CoolNamesAllTaken/geeps-hardware/README.md

# geeps-hardware
Pronounced Gee-Pee-Ess (hardware).
