CoolNamesAllTaken/geeps-hardware/excel/design_calculations.xlsx

Parameter | Value | Value | Value | Value | Unit | Note
Color | Red | Red | Green | Green
LED PN | SML-D12U8WT86 | SML-D12U8WT87 | SML-D12M8WT86 | SML-D12M8WT87
V_dd | 3.3 | 5 | 3.3 | 5 | V | Positive supply voltage.
V_f | 2.2 | 2.2 | 2.2 | 2.2 | V
LI_target | 12 | 12 | 12 | 12 | mcd | Target luminous intensity.
LI/I_f | 3.15 | 3.15 | 1.25 | 1.25 | mcd/mA
I_f | 3.81 | 3.81 | 9.60 | 9.60 | mA | Forward current.
R | 288.75 | 735 | 114.5833333 | 291.6666667 | Ohms
P_R | 0.004 | 0.011 | 0.011 | 0.027 | W | Power dissippated in resistor.
R (closest 1% standard value) | 287 | 732 | 115 | 294
Resistor PN | RC0402FR-07287RL | RC0402FR-07732RL | RC0402FR-07115RL | RC0402FR-07294RL
