CoolNamesAllTaken/geeps-hardware/solidworks/geeps_thtelth/decals/epaper_screenshot.jpg

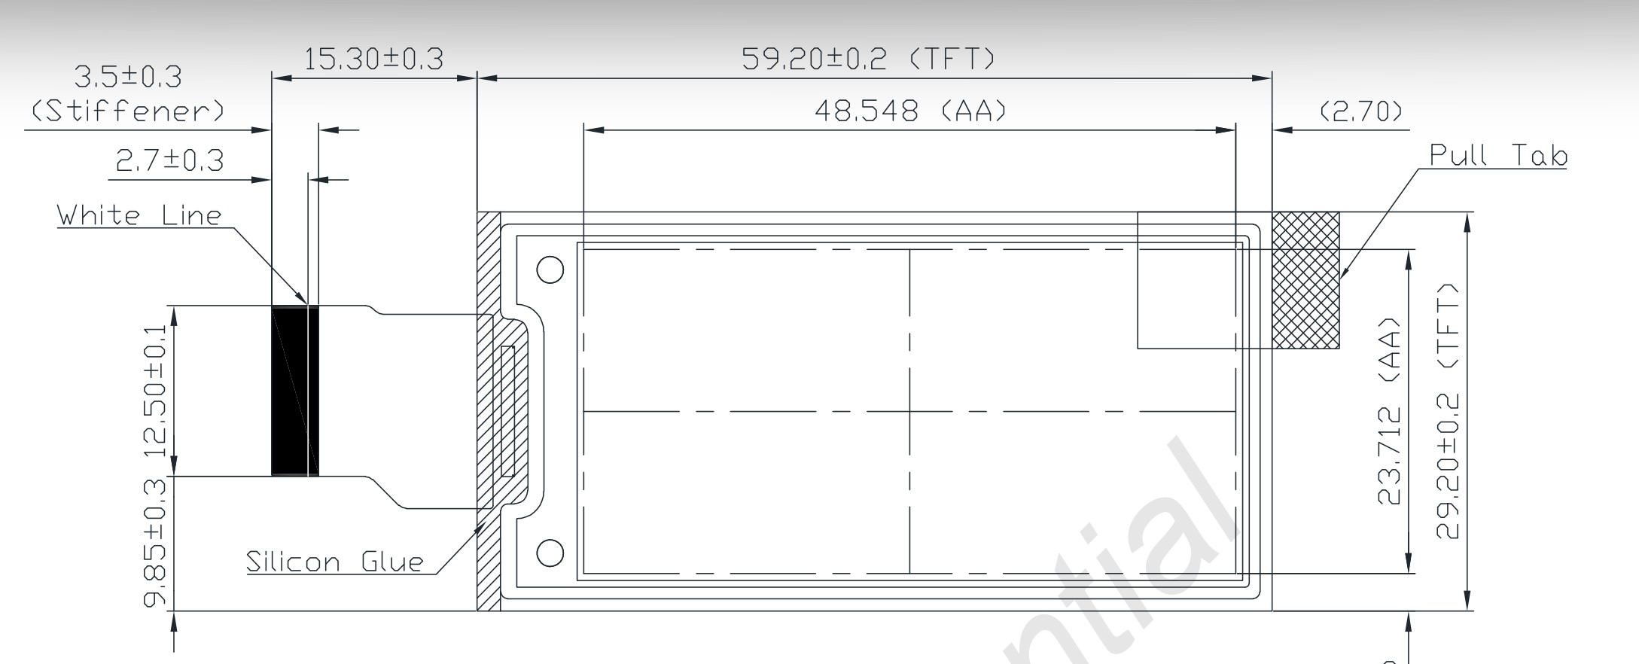
solidworks/geeps_thtelth/decals/epaper_screenshot.jpg
