CoolNamesAllTaken/geeps-hardware/solidworks/geeps_thtelth/exports/thelth_assy.STEP

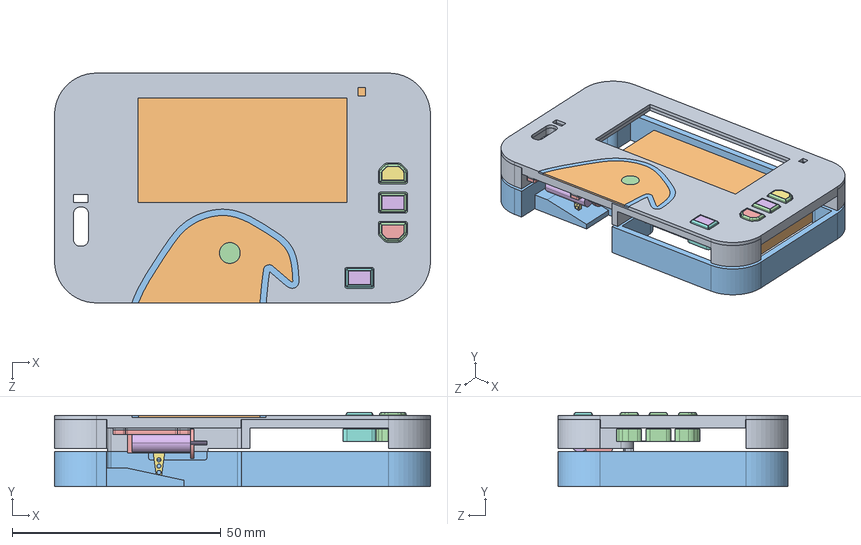
[picture p2: CAD file, 2025-03-13]
solidworks/geeps_thtelth/exports/thelth_assy.STEP
90.0 x 17.7 x 55.0 mm
cover^thelth_assy
battery^thelth_assy
frame^thelth_assy
nav_buttons
power_button^thelth_assy
face_plate^thelth_assy
micro_servo
