CoolNamesAllTaken/geeps-hardware/solidworks/geeps_thtelth/exports/frame^thelth_assy.STL

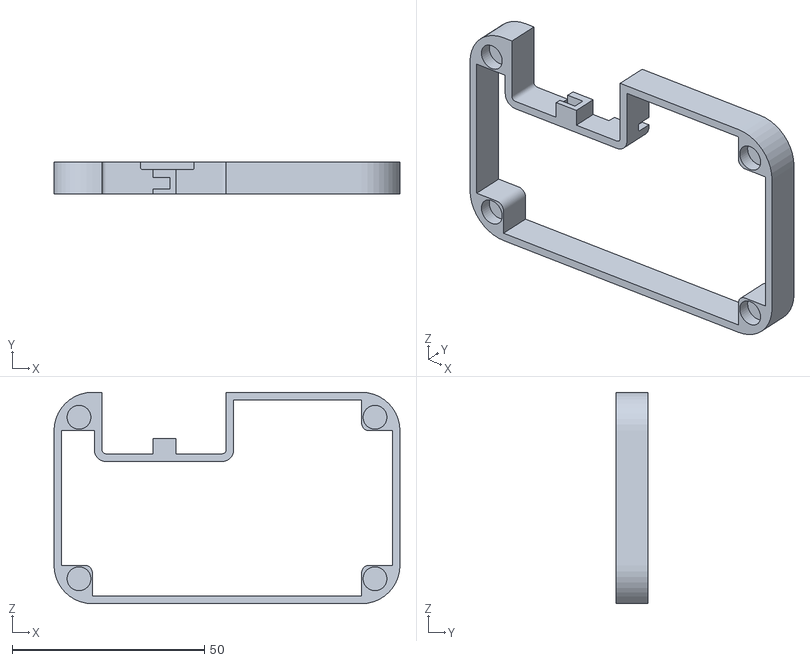
[picture p3: CAD file, 2025-03-13]
solidworks/geeps_thtelth/exports/frame^thelth_assy.STL
90.0 x 8.39 x 55.0
