CoolNamesAllTaken/geeps-hardware/solidworks/geeps_thtelth/exports/horn_ramp^micro_servo_assy_thelth_assy.STEP

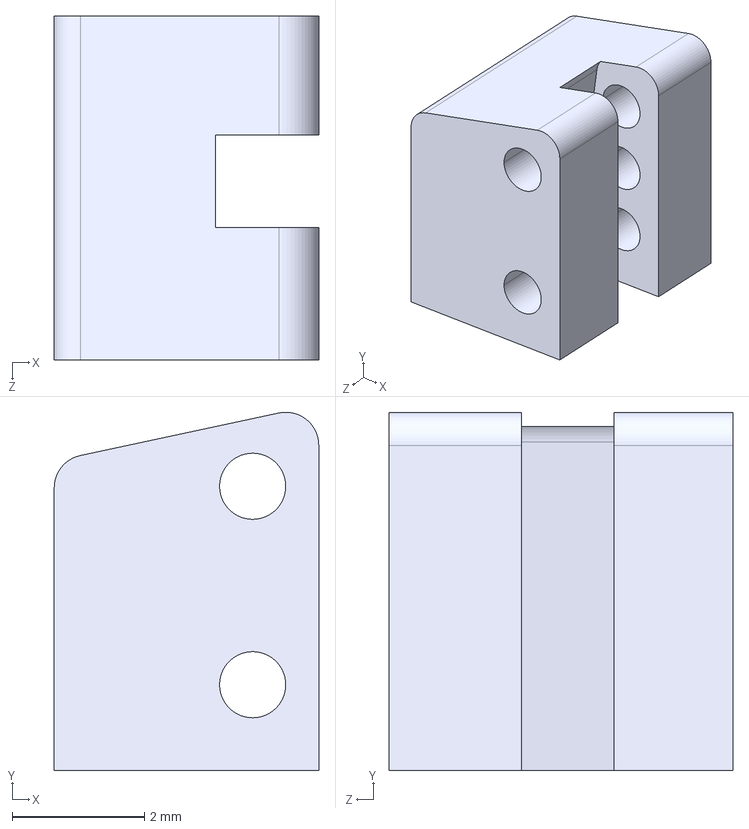
[picture p4: CAD file, 2025-03-13]
solidworks/geeps_thtelth/exports/horn_ramp^micro_servo_assy_thelth_assy.STEP
4.00 x 5.42 x 5.20 mm
