CoolNamesAllTaken/geeps-hardware/solidworks/geeps_thtelth/exports/latch^micro_servo_assy_thelth_assy.STL

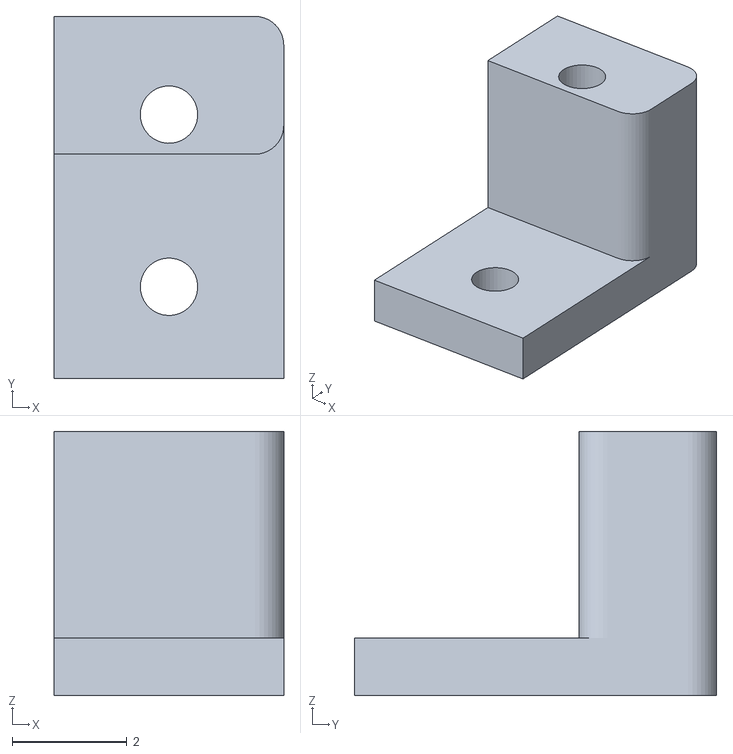
[picture p5: CAD file, 2025-03-13]
solidworks/geeps_thtelth/exports/latch^micro_servo_assy_thelth_assy.STL
4.00 x 6.31 x 4.60
