CoolNamesAllTaken/geeps-hardware/solidworks/geeps_thtelth/exports/face_plate^thelth_assy.STEP

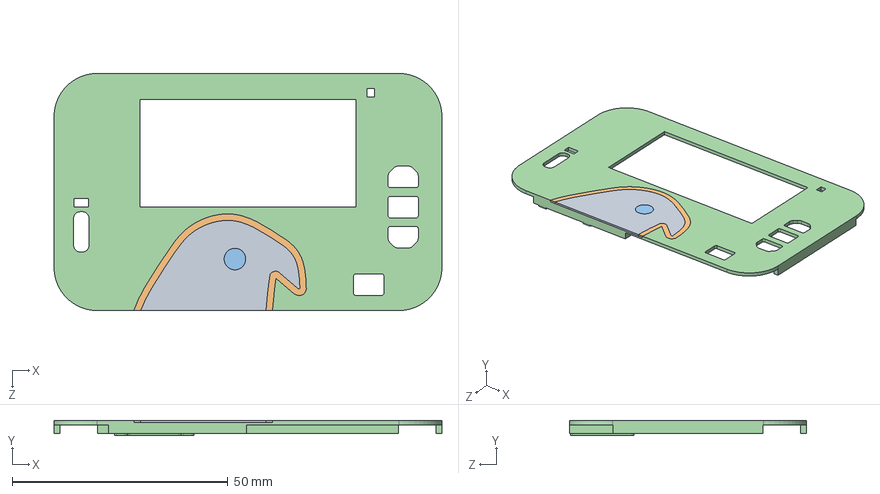
[picture p6: CAD file, 2025-03-13]
solidworks/geeps_thtelth/exports/face_plate^thelth_assy.STEP
90.0 x 3.50 x 55.0 mm
