CoolNamesAllTaken/geeps-hardware/affinity/scrub_jay_earrings/exports/scrub_jay_look_back.dxf

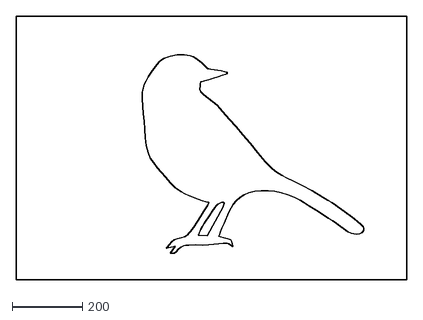
[picture p7: CAD file, 2025-03-13]
affinity/scrub_jay_earrings/exports/scrub_jay_look_back.dxf
1111.3 x 751.5
