CoolNamesAllTaken/geeps-hardware/kicad/gshps/exports/plots/drill/gshps-drill_map.dxf

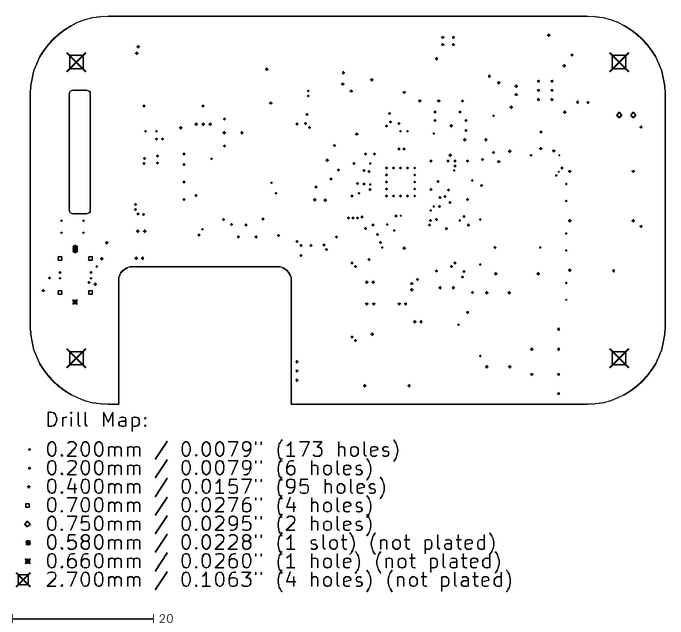
[picture p8: CAD file, 2025-03-13]
kicad/gshps/exports/plots/drill/gshps-drill_map.dxf
92.0 x 81.6
