CoolNamesAllTaken/geeps-hardware/onshape/jay_look_ahead.step

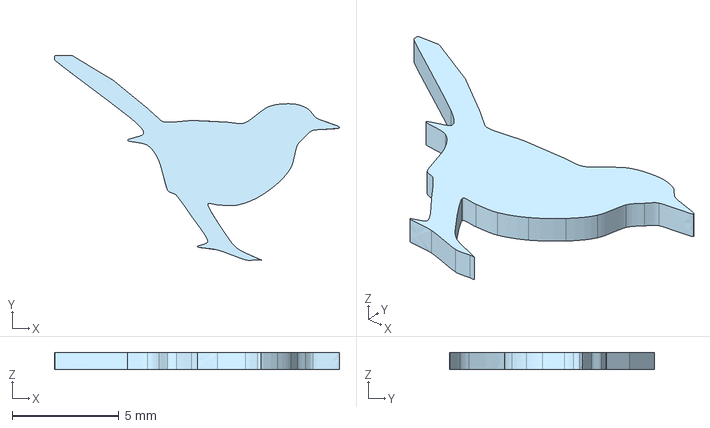
[picture p9: CAD file, 2025-03-13]
onshape/jay_look_ahead.step
13.4 x 9.60 x 0.8 mm
