CoolNamesAllTaken/geeps-hardware/solidworks/geeps_thtelth/epaper_display_E2213PS0E1.SLDPRT

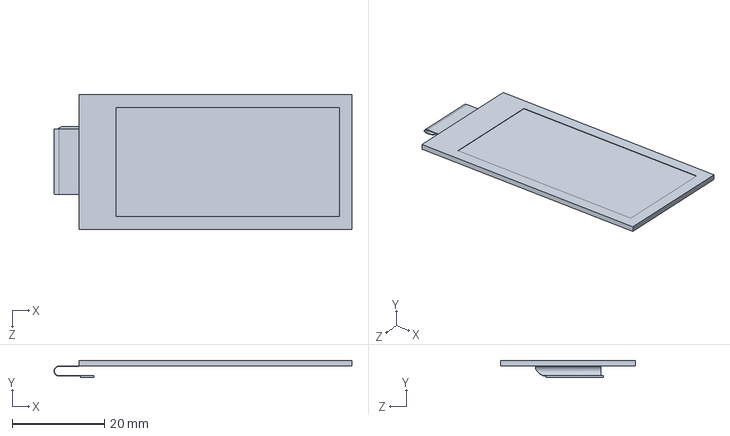
[picture p10: CAD file, 2025-03-13]
solidworks/geeps_thtelth/epaper_display_E2213PS0E1.SLDPRT
64.7 x 3.70 x 29.2 mm
