CoolNamesAllTaken/geeps-hardware/solidworks/geeps_thtelth/hardware/micro_servo.SLDPRT

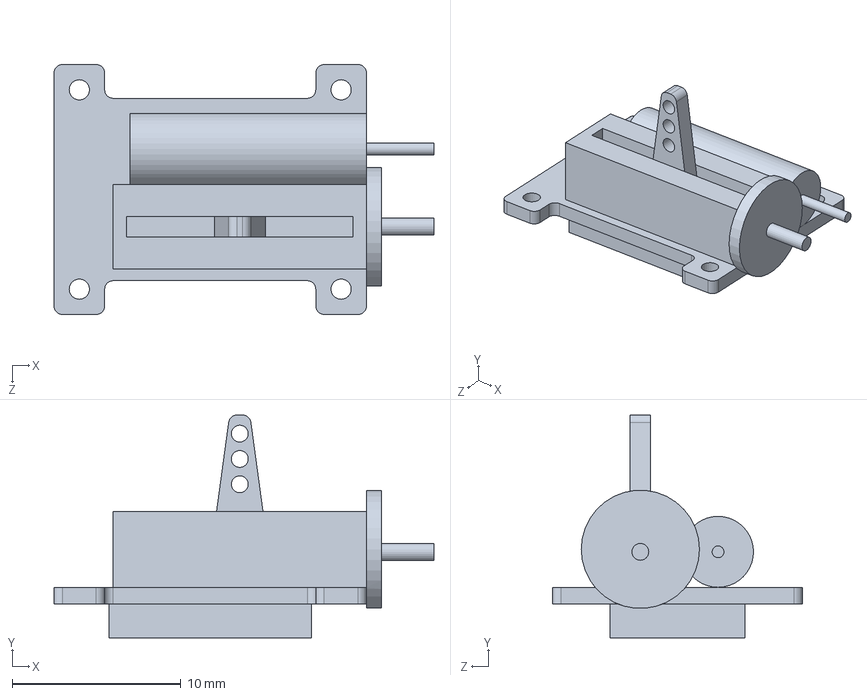
[picture p11: CAD file, 2025-03-13]
solidworks/geeps_thtelth/hardware/micro_servo.SLDPRT
22.5 x 13.2 x 14.8 mm
