CoolNamesAllTaken/geeps-hardware/solidworks/scrub_jay_earrings/scrub_jay_look_ahead_earring.SLDPRT

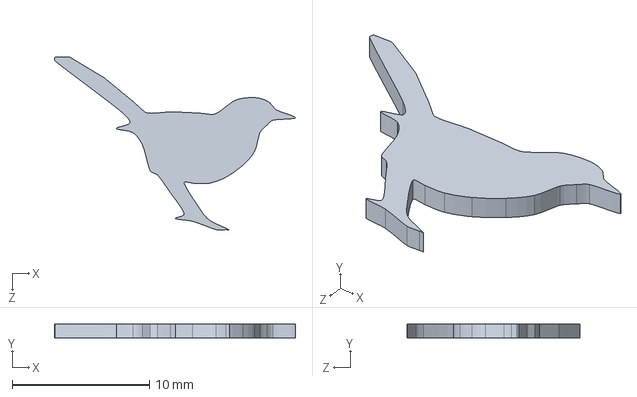
[picture p12: CAD file, 2025-03-13]
solidworks/scrub_jay_earrings/scrub_jay_look_ahead_earring.SLDPRT
17.6 x 1.00 x 12.6 mm
