CoolNamesAllTaken/geeps-hardware/affinity/scrub_jay_earrings/exports/scrub_jay_look_ahead.dxf

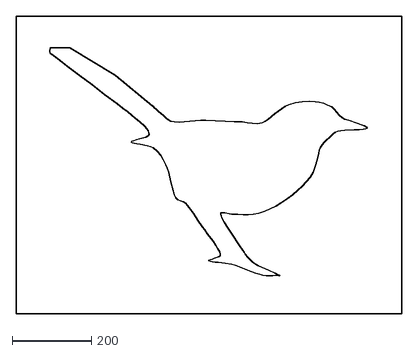
[picture p13: CAD file, 2025-03-13]
affinity/scrub_jay_earrings/exports/scrub_jay_look_ahead.dxf
975.0 x 751.5
