CoolNamesAllTaken/geeps-hardware/onshape/scrub_jay_16x_bigleg.step

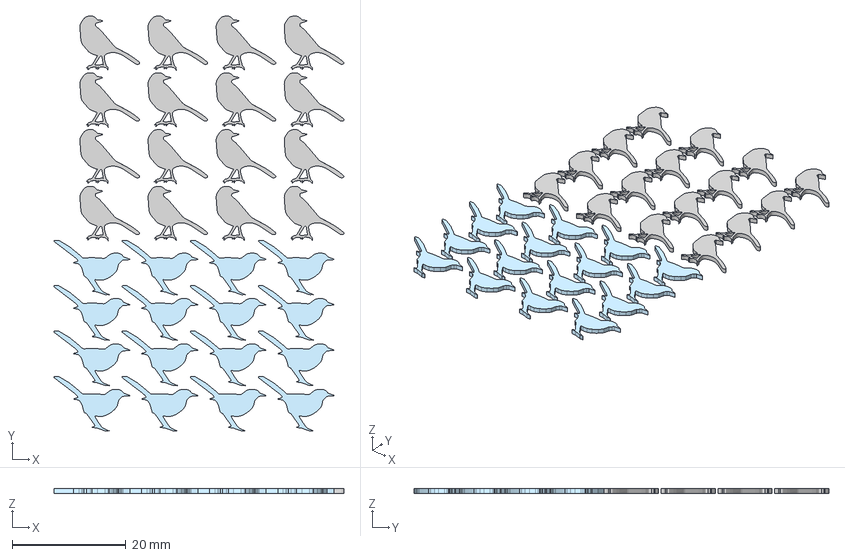
[picture p14: CAD file, 2025-03-13]
onshape/scrub_jay_16x_bigleg.step
51.1 x 73.1 x 0.8 mm
