CoolNamesAllTaken/geeps-hardware/solidworks/scrub_jay_earrings/4x12mm_earring_post.SLDPRT

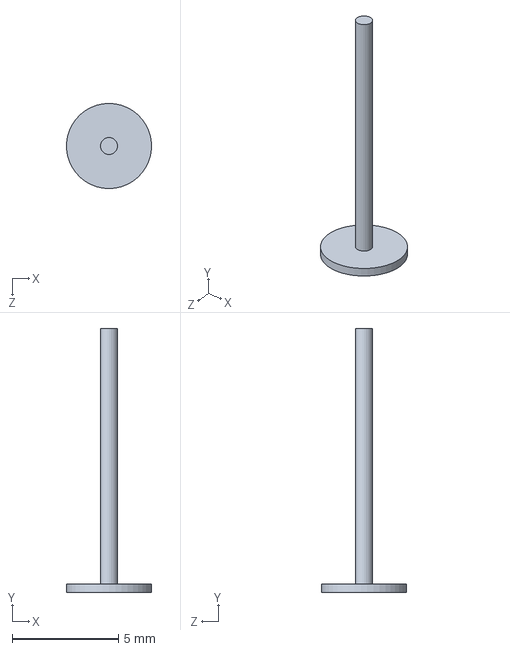
[picture p15: CAD file, 2025-03-13]
solidworks/scrub_jay_earrings/4x12mm_earring_post.SLDPRT
3.99 x 12.4 x 4.00 mm
