CoolNamesAllTaken/geeps-hardware/affinity/scrub_jay_earrings/exports/scrub_jay_look_back_bigleg.dxf

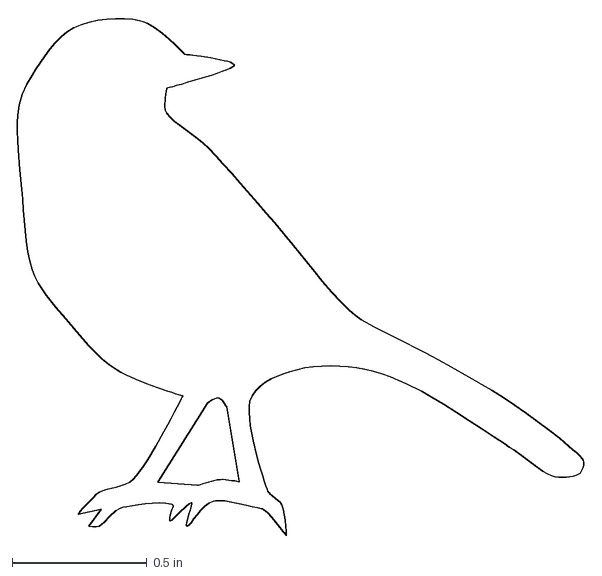
[picture p16: CAD file, 2025-03-13]
affinity/scrub_jay_earrings/exports/scrub_jay_look_back_bigleg.dxf
2.11 x 1.93 in
