CoolNamesAllTaken/geeps-hardware/onshape/jay_look_behind.step

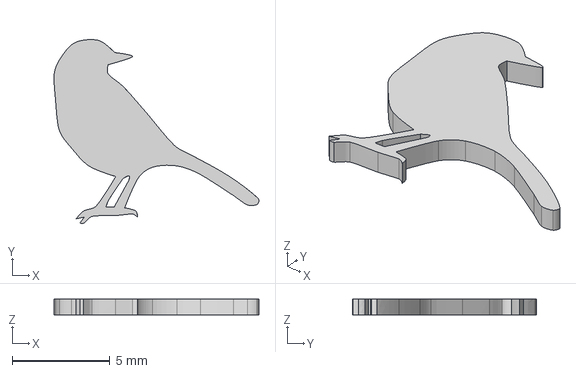
[picture p17: CAD file, 2025-03-13]
onshape/jay_look_behind.step
10.5 x 9.43 x 0.8 mm
