CoolNamesAllTaken/geeps-hardware/solidworks/geeps_thtelth/top_wireframe.DXF

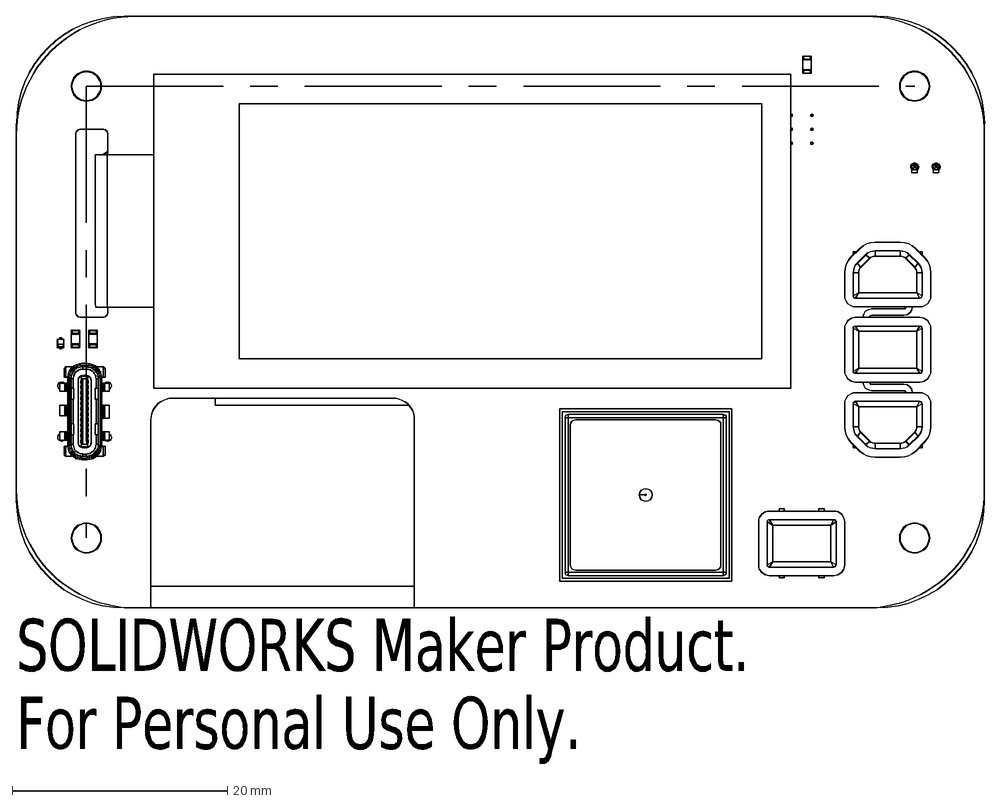
[picture p18: CAD file, 2025-03-13]
solidworks/geeps_thtelth/top_wireframe.DXF
SOLIDWORKS Maker Product.
For Personal Use Only.
