CoolNamesAllTaken/geeps-hardware/solidworks/geeps_thtelth/bottom_wireframe.DXF

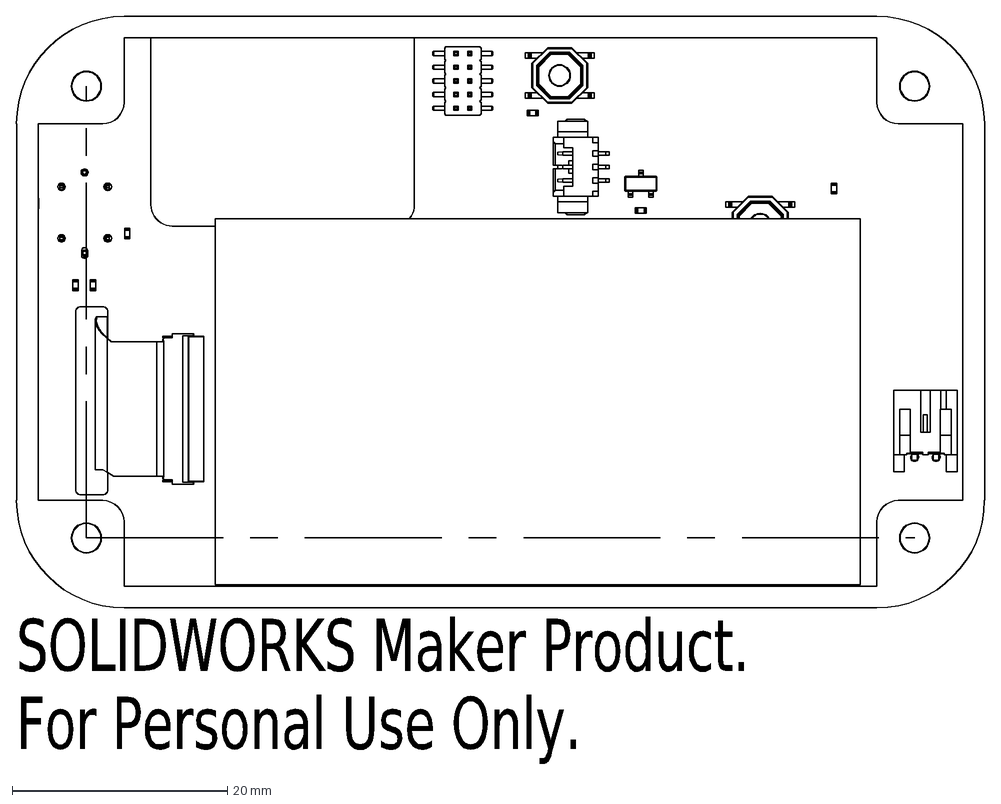
[picture p19: CAD file, 2025-03-13]
solidworks/geeps_thtelth/bottom_wireframe.DXF
SOLIDWORKS Maker Product.
For Personal Use Only.
