CoolNamesAllTaken/geeps-hardware/solidworks/geeps_thtelth/pcb_outline.DXF

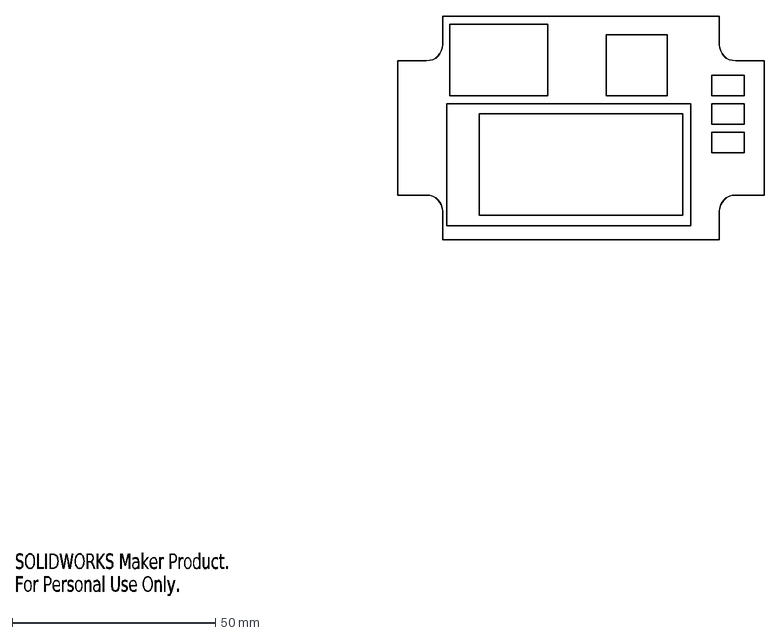
[picture p20: CAD file, 2025-03-13]
solidworks/geeps_thtelth/pcb_outline.DXF
SOLIDWORKS Maker Product.
For Personal Use Only.
