CoolNamesAllTaken/geeps-hardware/solidworks/geeps_thtelth/thelth_volume.SLDPRT

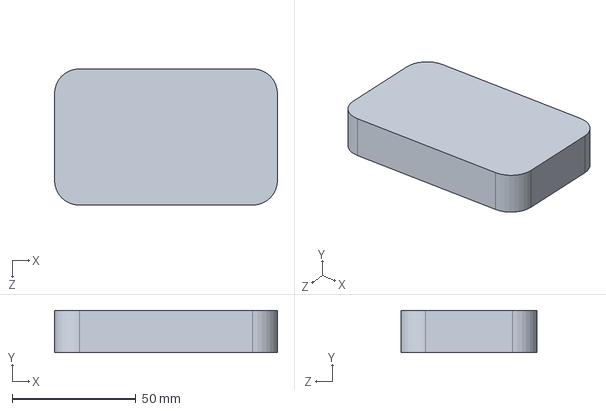
[picture p21: CAD file, 2023-06-24]
solidworks/geeps_thtelth/thelth_volume.SLDPRT
90.0 x 17.0 x 55.0 mm
