CoolNamesAllTaken/geeps-hardware/solidworks/geeps_thtelth/geeps_pcba.SLDASM

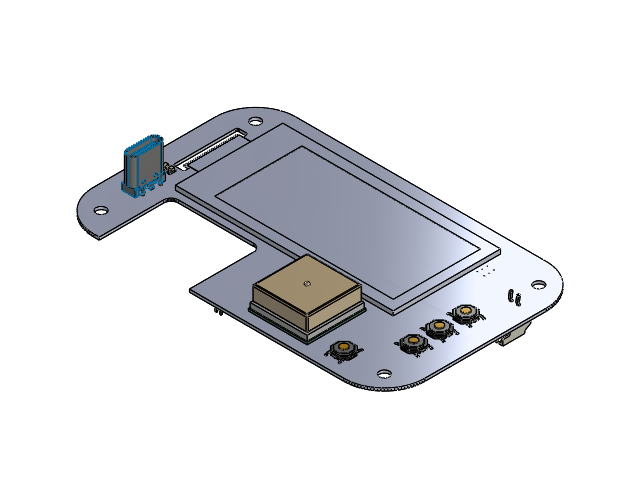
[picture p22: CAD file, 2025-03-13]
solidworks/geeps_thtelth/geeps_pcba.SLDASM
geeps_mk1
epaper_display_E2213PS0E1
