CoolNamesAllTaken/geeps-hardware/(list of files, cad)

Other CAD files:
solidworks/geeps_thtelth/nav_buttons.SLDPRT
solidworks/scrub_jay_earrings/scrub_jay_look_ahead.SLDPRT
onshape/jay_look_ahead.dxf
onshape/jay_look_ahead.stl
onshape/jay_look_behind.dxf
onshape/jay_look_behind.stl
solidworks/geeps_thtelth/epaper_display_E2213PS0E1.SLDDRW
solidworks/geeps_thtelth/exports/face_plate^thelth_assy.3mf
solidworks/geeps_thtelth/hardware/9271K269_Torsion Spring.SLDPRT
solidworks/geeps_thtelth/kea.SLDDRW
solidworks/geeps_thtelth/pcb_outline.SLDDRW
solidworks/geeps_thtelth/thelth_assy.SLDASM
