CoolNamesAllTaken/geeps-hardware/kicad/gshps/exports/plots/drill/gshps-drill_map.pdf

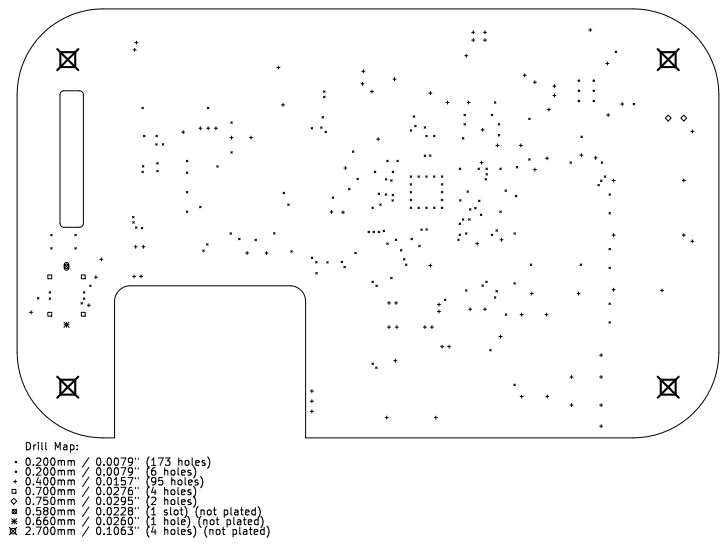
[picture p26: page 1]
