CoolNamesAllTaken/geeps-hardware/ltspice/power_switch/push_on_hold_off_tran.asc

C1: cap; 1µ
C2: cap; 10µ
C3: cap; 0.1µ
D1: diode; d_ideal
M1: pmos; Si4433DY
M2: nmos; 2n7002
R1: res; 10k
R2: res; 100k
R3: res; 100k
R4: res; 100k
R5: res; 10
S1: sw; sw_ideal
V1: voltage; PULSE(0 5 10m 1n 1n 100m 400m 1)
V2: voltage; 5
V3: voltage; PULSE(0 5 500m 1n 1n 5 10 1)
Named nets: 0, sw_enable, 5v, out
.model sw_ideal SW(Ron=1m Roff=1G Vt=2.5 Vh=-0.5)
.model d_ideal D(Ron=1m Roff=1Meg Vfwd=0.4)
.tran 0 5 0
HOLD OFF
PUSH ON
