CoolNamesAllTaken/geeps-hardware/kicad/gshps/gshps.kicad_pcb

## KiCad design kicad/gshps/gshps.kicad_pcb (2025-03-13)

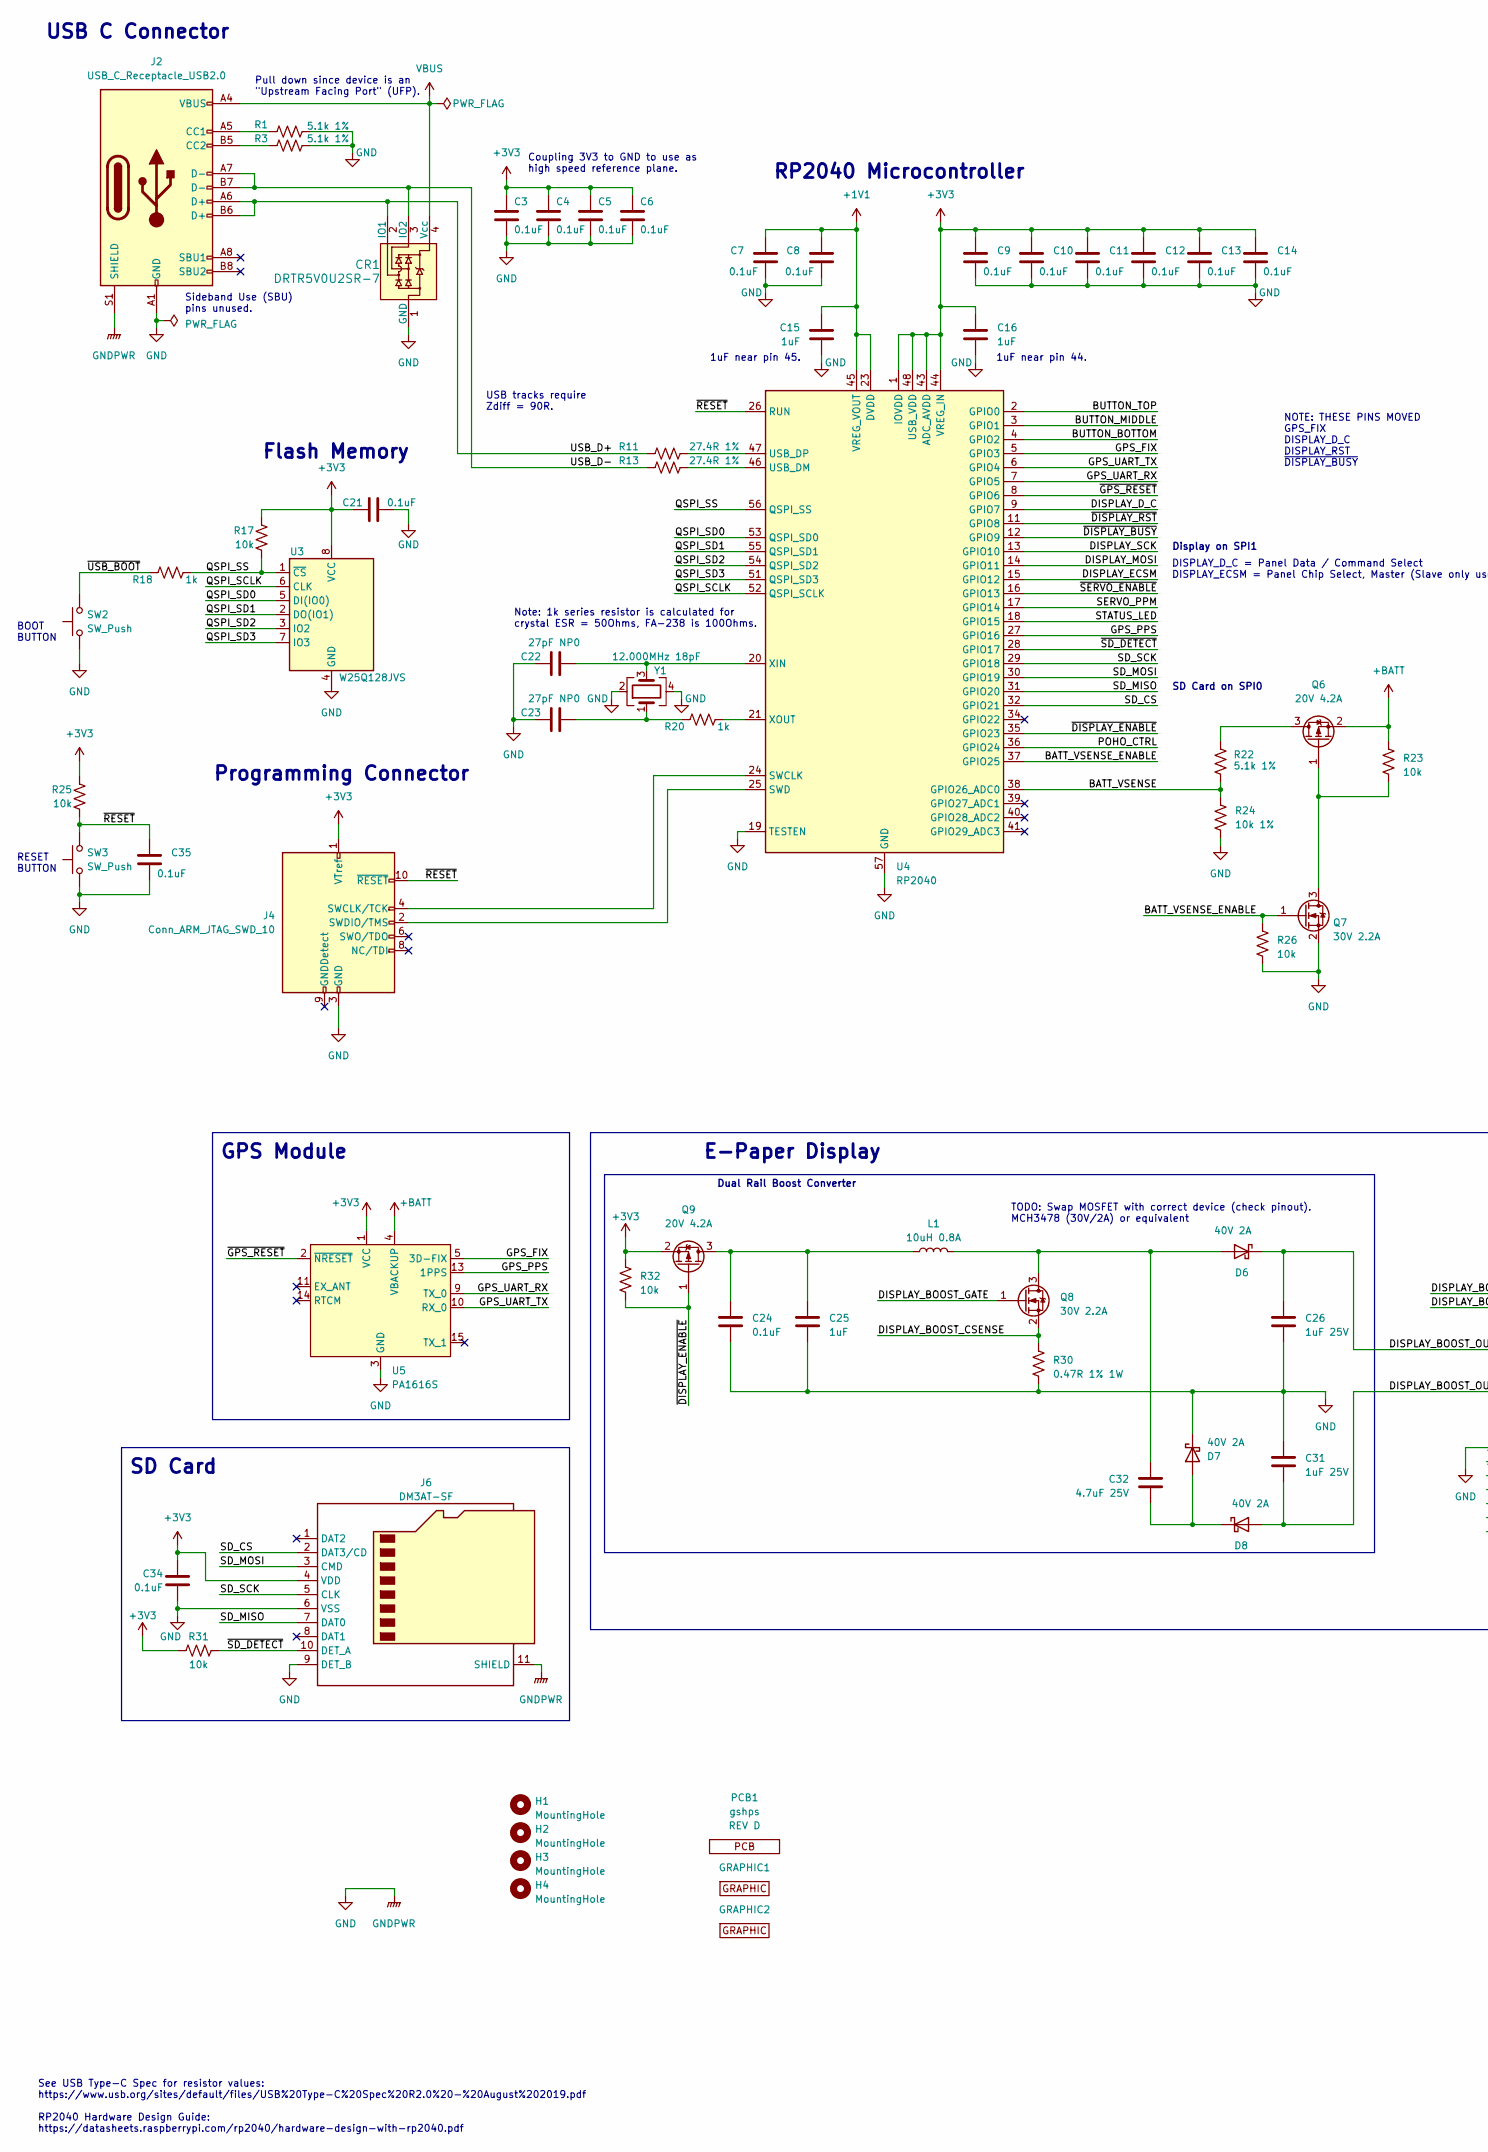
[picture p27: schematic gshps.kicad_sch, Global Scavenger Hunt Positioning System, part in row 1, column 1]

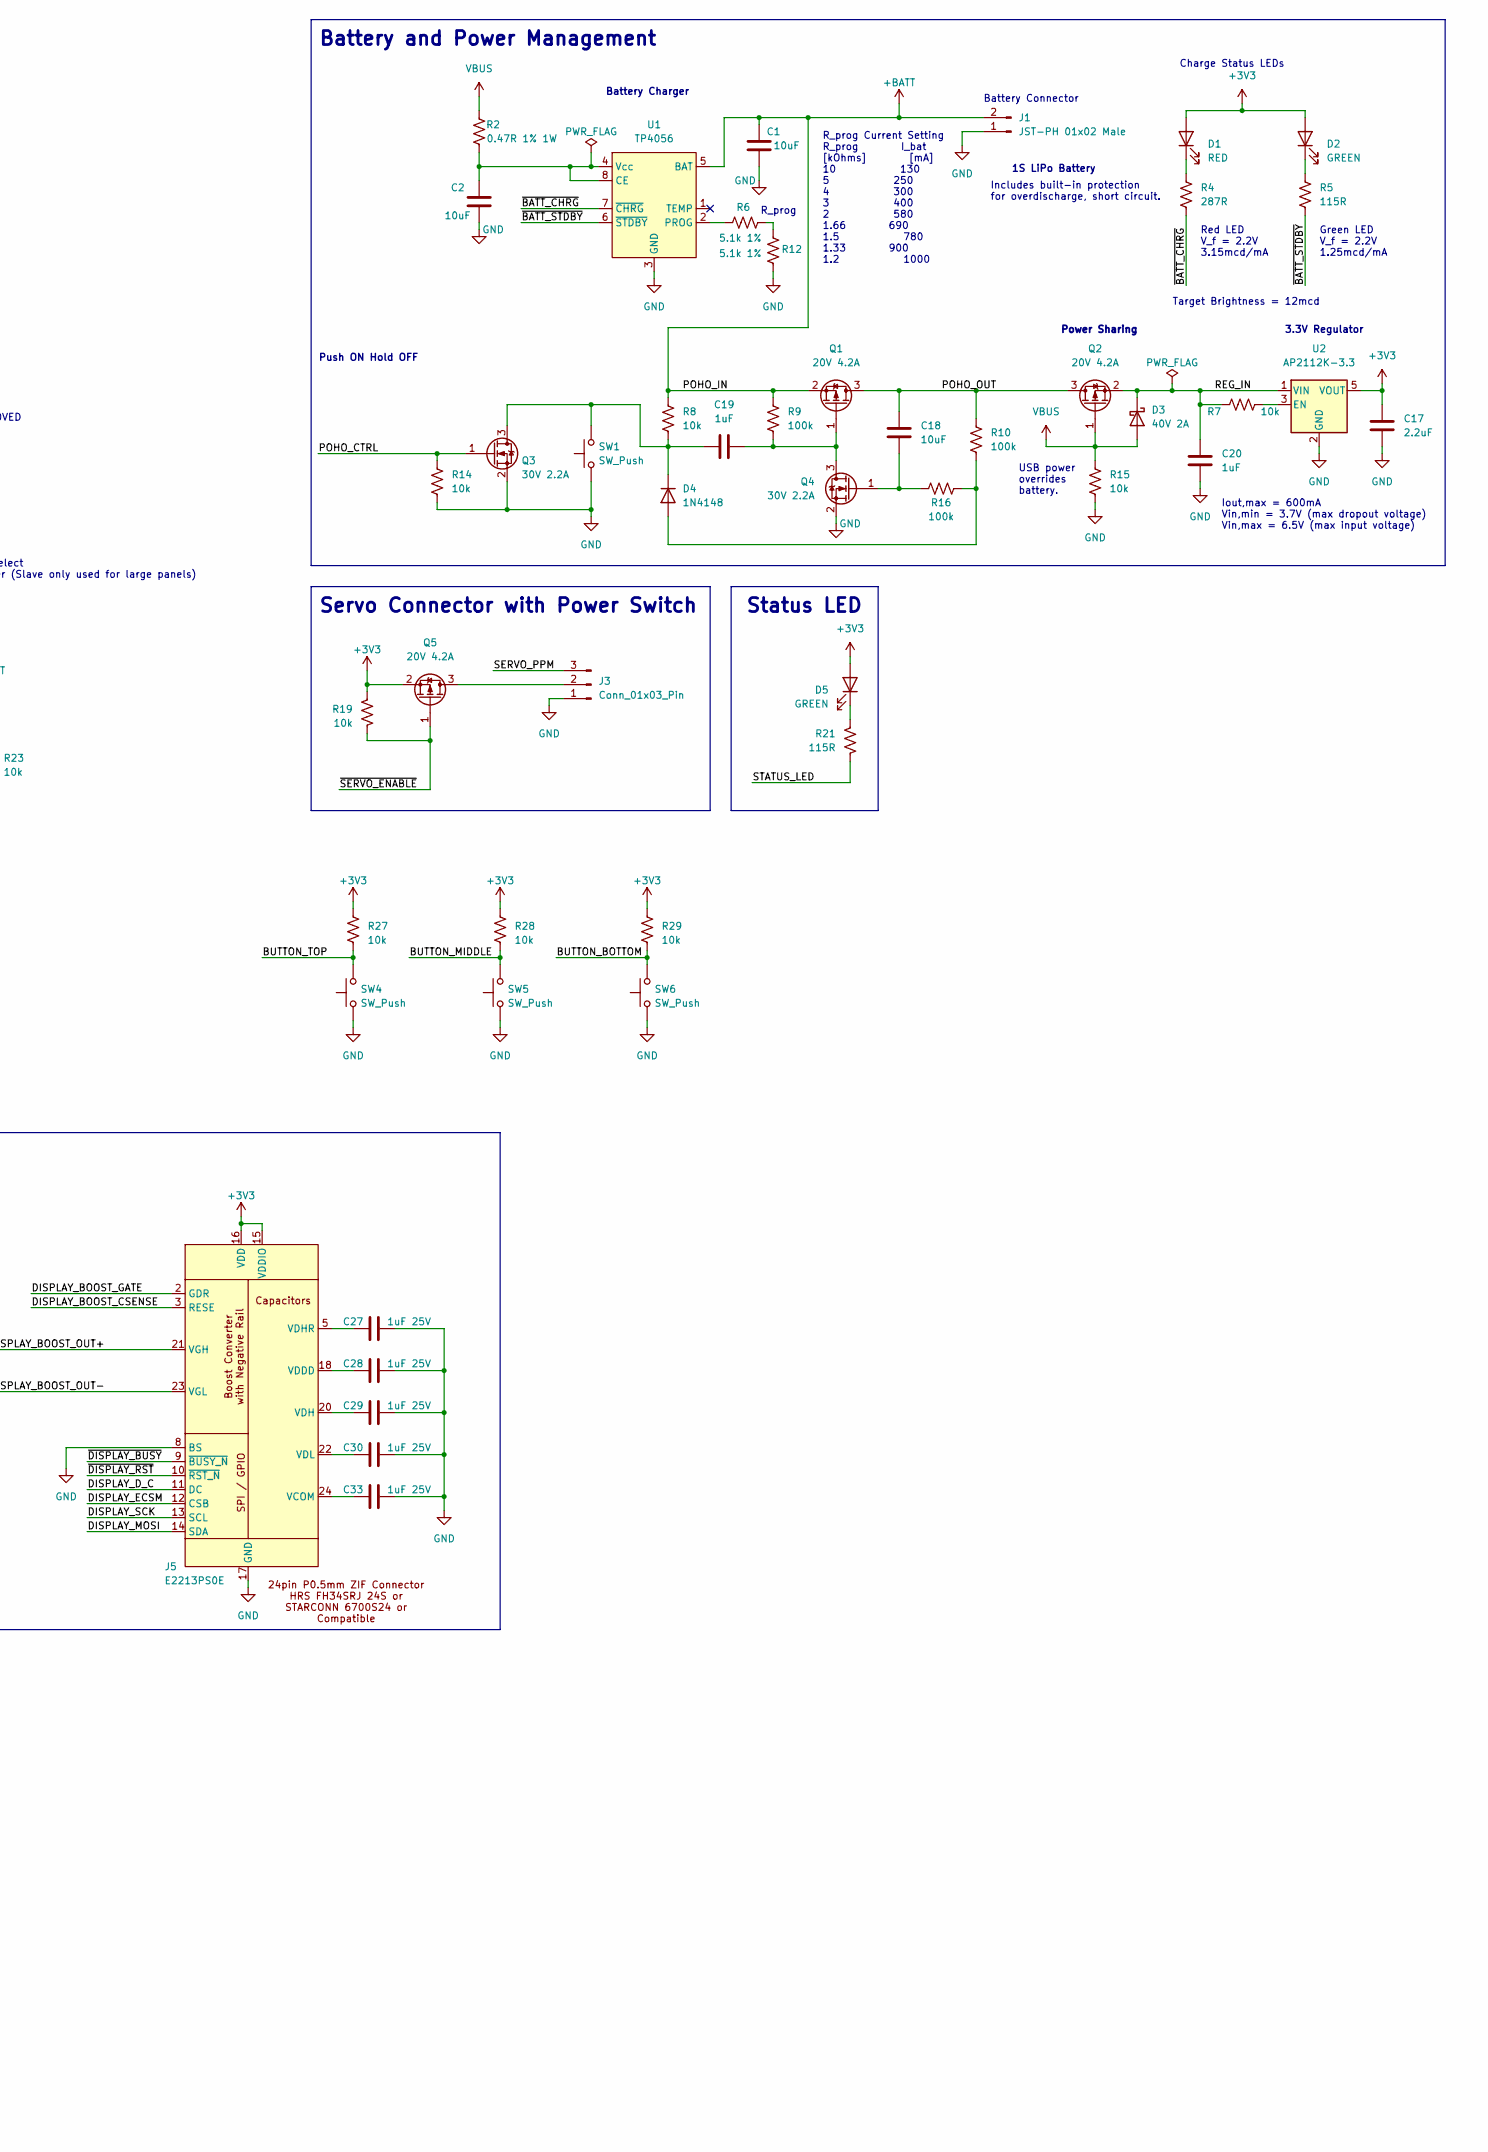
[picture p28: schematic gshps.kicad_sch, Global Scavenger Hunt Positioning System, part in row 1, column 2]

Parts:
C1, C2, C18: 10uF; C_0805_2012Metric
C3, C4, C5, C6, C7, C8, C9, C10, C11, C12, C13, C14, C21, C24, C34, C35: 0.1uF; C_0402_1005Metric
C15, C16, C19, C20, C25: 1uF; C_0603_1608Metric
C17: 2.2uF; C_0603_1608Metric
C22, C23: 27pF NP0; C_0402_1005Metric
C26, C27, C28, C29, C30, C31, C33: 1uF 25V; C_0603_1608Metric
C32: 4.7uF 25V; C_0805_2012Metric
CR1: DRTR5V0U2SR-7; SOT-143; MPN DRTR5V0U2SR-7
D1: RED; LED_0603_1608Metric; MPN SML-D12U8WT86
D2, D5: GREEN; LED_0603_1608Metric; MPN SML-D12M8WT86
D3, D6, D7, D8: 40V 2A; D_SOD-123F; MPN SS2040FL_R1_00001
D4: 1N4148; D_SOD-123
GRAPHIC1: Graphic; BirdWithPants_Small_Right
GRAPHIC2: Graphic; BirdWithPants_Small_Left
H1, H2, H3, H4: MountingHole; MountingHole_2.7mm_M2.5_Isolated
J1: JST-PH 01x02 Male; JST_PH_S2B-PH-K_1x02_P2.00mm_Horizontal; MPN S2B-PH-K-S(LF)(SN)
J2: USB_C_Receptacle_USB2.0; USB_C_Receptacle_GCT_USB4115-03-C; MPN USB4115-03-C
J3: Conn_01x03_Pin; Molex_PicoBlade_53261-0371_1x03-1MP_P1.25mm_Horizontal; MPN 0532610371
J4: Conn_ARM_JTAG_SWD_10; PinHeader_2x05_P1.27mm_Vertical_SMD; MPN 4048
J5: E2213PS0E; Hirose_FH34SRJ-24S-0.5SH_1x24-1MP_P0.50mm_Horizontal_Mirror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; MPN FH34SRJ-24S-0.5SH(50)
J6: DM3AT-SF; microSD_HC_Hirose_DM3D-SF; MPN DM3AT-SF-PEJM5
L1: 10uH 0.8A; L_1008_2520Metric; MPN 74479887310A
PCB1: PCB; PCB_PN_REV; MPN gshps
Q1, Q2, Q5, Q6, Q9: 20V 4.2A; SOT-23; MPN DMG2305UX-7
Q3, Q4, Q7, Q8: 30V 2.2A; SOT-23; MPN DMN3200U-7
R1, R3, R6, R12, R22: 5.1k 1%; R_0402_1005Metric
R2, R30: 0.47R 1% 1W; R_2512_6332Metric; MPN RL2512FK-070R47L
R4: 287R; R_0402_1005Metric; MPN RC0402FR-07287RL
R5, R21: 115R; R_0402_1005Metric; MPN RC0402FR-07115RL
R7, R8, R14, R15, R17, R19, R23, R25, R26, R27, R28, R29, R31, R32: 10k; R_0402_1005Metric
R9, R10, R16: 100k; R_0402_1005Metric
R11, R13: 27.4R 1%; R_0402_1005Metric
R18, R20: 1k; R_0402_1005Metric
R24: 10k 1%; R_0402_1005Metric
SW1, SW2, SW3, SW4, SW5, SW6: SW_Push; SW_SPST_TL3342; MPN TL3342F160QG/TR
U1: TP4056; HSOP-8-1EP_3.9x4.9mm_P1.27mm_EP2.41x3.1mm_ThermalVias
U2: AP2112K-3.3; SOT-23-5; MPN AP2112K-3.3TRG1
U3: W25Q128JVS; SOIC-8_5.23x5.23mm_P1.27mm
U4: RP2040; QFN-56-1EP_7x7mm_P0.4mm_EP3.2x3.2mm
U5: PA1616S; MPN PA1616S
Y1: 12.000MHz 18pF; Crystal_SMD_SeikoEpson_FA238-4Pin_3.2x2.5mm; MPN FA-238V 12.0000MA-C5

Connections:
+1V1: C7.2, C8.2, C15.2, U4.23 (DVDD), U4.45 (VREG_VOUT), U4.50 (DVDD)
+3V3: C3.2, C4.2, C5.2, C6.2, C9.2, C10.2, C11.2, C12.2, C13.2, C14.2, C16.2, C17.1, C21.1, C34.1, D1.2 (A), D2.2 (A), D5.2 (A), J4.1 (VTref), J5.15 (VDDIO), J5.16 (VDD), J6.4 (VDD), Q5.2 (S), Q9.2 (S), R17.1, R19.1, R25.1, R27.1, R28.1, R29.1, R31.1, R32.1, U2.5 (VOUT), U3.8 (VCC), U4.1 (IOVDD), U4.10 (IOVDD), U4.22 (IOVDD), U4.33 (IOVDD), U4.42 (IOVDD), U4.43 (ADC_AVDD), U4.44 (VREG_IN), U4.48 (USB_VDD), U4.49 (IOVDD), U5.1 (VCC)
+BATT: C1.1, J1.2, Q1.2 (S), Q6.2 (S), R8.1, R9.1, R23.1, U1.5 (BAT), U5.4 (VBACKUP)
/BATT_VSENSE: R22.1, R24.1, U4.38 (GPIO26_ADC0)
/BATT_VSENSE_ENABLE: Q7.1 (G), R26.1, U4.37 (GPIO25)
/BUTTON_BOTTOM: R29.2, SW6.2, U4.4 (GPIO2)
/BUTTON_MIDDLE: R28.2, SW5.2, U4.3 (GPIO1)
/BUTTON_TOP: R27.2, SW4.2, U4.2 (GPIO0)
/DISPLAY_BOOST_CSENSE: J5.3 (RESE), Q8.2 (S), R30.1
/DISPLAY_BOOST_GATE: J5.2 (GDR), Q8.1 (G)
/DISPLAY_BOOST_OUT+: C26.1, D6.1 (K), J5.21 (VGH)
/DISPLAY_BOOST_OUT-: C31.2, D8.2 (A), J5.23 (VGL)
/DISPLAY_D_C: J5.11 (DC), U4.9 (GPIO7)
/DISPLAY_ECSM: J5.12 (CSB), U4.15 (GPIO12)
/DISPLAY_MOSI: J5.14 (SDA), U4.14 (GPIO11)
/DISPLAY_SCK: J5.13 (SCL), U4.13 (GPIO10)
/GPS_FIX: U4.5 (GPIO3), U5.5 (3D-FIX)
/GPS_PPS: U4.27 (GPIO16), U5.13 (1PPS)
/GPS_UART_RX: U4.7 (GPIO5), U5.9 (TX_0)
/GPS_UART_TX: U4.6 (GPIO4), U5.10 (RX_0)
/POHO_CTRL: Q3.1 (G), R14.1, U4.36 (GPIO24)
/POHO_OUT: C18.1, Q1.3 (D), Q2.3 (D), R10.1
/QSPI_SCLK: U3.6 (CLK), U4.52 (QSPI_SCLK)
/QSPI_SD0: U3.5 (DI(IO0)), U4.53 (QSPI_SD0)
/QSPI_SD1: U3.2 (DO(IO1)), U4.55 (QSPI_SD1)
/QSPI_SD2: U3.3 (IO2), U4.54 (QSPI_SD2)
/QSPI_SD3: U3.7 (IO3), U4.51 (QSPI_SD3)
/QSPI_SS: R17.2, R18.2, U3.1 (~CS), U4.56 (QSPI_SS)
/REG_IN: C20.1, D3.1 (K), Q2.2 (S), R7.1, U2.1 (VIN)
/SD_CS: J6.2 (DAT3/CD), U4.32 (GPIO21)
/SD_MISO: J6.7 (DAT0), U4.31 (GPIO20)
/SD_MOSI: J6.3 (CMD), U4.30 (GPIO19)
/SD_SCK: J6.5 (CLK), U4.29 (GPIO18)
/SERVO_PPM: J3.3, U4.17 (GPIO14)
/STATUS_LED: R21.2, U4.18 (GPIO15)
/USB_D+: CR1.2 (IO1), J2.A6 (D+), J2.B6 (D+), R11.1
/USB_D-: CR1.3 (IO2), J2.A7 (D-), J2.B7 (D-), R13.1
/~BATT_CHRG: R4.2, U1.7 (~CHRG)
/~BATT_STDBY: R5.2, U1.6 (~STDBY)
/~DISPLAY_BUSY: J5.9 (~BUSY_N), U4.12 (GPIO9)
/~DISPLAY_ENABLE: Q9.1 (G), R32.2, U4.35 (GPIO23)
/~DISPLAY_RST: J5.10 (~RST_N), U4.11 (GPIO8)
/~GPS_RESET: U4.8 (GPIO6), U5.2 (~NRESET)
/~RESET: C35.2, J4.10 (~RESET), R25.2, SW3.2, U4.26 (RUN)
/~SD_DETECT: J6.10 (DET_A), R31.2, U4.28 (GPIO17)
/~SERVO_ENABLE: Q5.1 (G), R19.2, U4.16 (GPIO13)
/~USB_BOOT: R18.1, SW2.2
GND: C1.2, C2.2, C3.1, C4.1, C5.1, C6.1, C7.1, C8.1, C9.1, C10.1, C11.1, C12.1, C13.1, C14.1, C15.1, C16.1, C17.2, C20.2, C21.2, C22.1, C23.1, C24.2, C25.2, C26.2, C27.2, C28.2, C29.2, C30.2, C31.1, C33.2, C34.2, C35.1, CR1.1 (GND), D7.1 (K), J1.1, J2.A1 (GND), J2.A12 (GND), J2.B1 (GND), J2.B12 (GND), J2.S1 (SHIELD), J3.1, J4.3 (GND), J4.5 (GND), J5.8 (BS), J5.17 (GND), J6.6 (VSS), J6.9 (DET_B), J6.11 (SHIELD), Q3.2 (S), Q4.2 (S), Q7.2 (S), R1.2, R3.2, R12.1, R14.2, R15.2, R24.2, R26.2, R30.2, SW1.1, SW2.1, SW3.1, SW4.1, SW5.1, SW6.1, U1.3 (GND), U1.9 (GND), U2.2 (GND), U3.4 (GND), U4.19 (TESTEN), U4.57 (GND), U5.3 (GND), U5.8 (GND), U5.12 (GND), U5.19 (GND), Y1.2, Y1.4
unnamed: C23.2, R20.1, Y1.1
unnamed: D1.1 (K), R4.1
unnamed: D2.1 (K), R5.1
unnamed: D4.2 (A), R10.2, R16.2
unnamed: C19.1, D4.1 (K), Q3.3 (D), R8.2, SW1.2
unnamed: D5.1 (K), R21.1
unnamed: C32.1, D6.2 (A), L1.2, Q8.3 (D)
unnamed: C32.2, D7.2 (A), D8.1 (K)
unnamed: J2.A5 (CC1), R1.1
unnamed: J2.B5 (CC2), R3.1
unnamed: J3.2, Q5.3 (D)
unnamed: J4.4 (SWCLK/TCK), U4.24 (SWCLK)
unnamed: J4.2 (SWDIO/TMS), U4.25 (SWD)
unnamed: C33.1, J5.24 (VCOM)
unnamed: C28.1, J5.18 (VDDD)
unnamed: C29.1, J5.20 (VDH)
unnamed: C27.1, J5.5 (VDHR)
unnamed: C30.1, J5.22 (VDL)
unnamed: C19.2, Q1.1 (G), Q4.3 (D), R9.2
unnamed: C18.2, Q4.1 (G), R16.1
unnamed: Q6.3 (D), R22.2
unnamed: Q6.1 (G), Q7.3 (D), R23.2
unnamed: C24.1, C25.1, L1.1, Q9.3 (D)
unnamed: R6.2, R12.2
unnamed: C2.1, R2.2, U1.4 (Vcc), U1.8 (CE)
unnamed: R6.1, U1.2 (PROG)
unnamed: R7.2, U2.3 (EN)
unnamed: R13.2, U4.46 (USB_DM)
unnamed: R11.2, U4.47 (USB_DP)
unnamed: C22.2, U4.20 (XIN), Y1.3
unnamed: R20.2, U4.21 (XOUT)
VBUS: CR1.4 (Vcc), D3.2 (A), J2.A4 (VBUS), J2.A9 (VBUS), J2.B4 (VBUS), J2.B9 (VBUS), Q2.1 (G), R2.1, R15.1

Notes on the sheet:
NOTE: THESE PINS MOVED GPS_FIX DISPLAY_D_C DISPLAY_RST ~{DISPLAY_BUSY}
Flash Memory
1uF near pin 45.
Red LED V_f = 2.2V 3.15mcd/mA
Battery Connector
TODO: Swap MOSFET with correct device (check pinout). MCH3478 (30V/2A) or equivalent
DISPLAY_D_C = Panel Data / Command Select DISPLAY_ECSM = Panel Chip Select, Master (Slave only used for large panels)
SD Card
USB power overrides battery.
3.3V Regulator
USB tracks require Zdiff = 90R.
Battery Charger
Power Sharing
Iout,max = 600mA Vin,min = 3.7V (max dropout voltage) Vin,max = 6.5V (max input voltage)
Battery and Power Management
Push ON Hold OFF
Servo Connector with Power Switch
Green LED V_f = 2.2V 1.25mcd/mA
GPS Module
Display on SPI1
Status LED
Dual Rail Boost Converter
Coupling 3V3 to GND to use as high speed reference plane.
SD Card on SPI0
RESET BUTTON
Charge Status LEDs
Programming Connector
BOOT BUTTON
1uF near pin 44.
E-Paper Display
RP2040 Microcontroller
Note: 1k series resistor is calculated for crystal ESR = 50Ohms, FA-238 is 100Ohms.
Target Brightness = 12mcd
R_prog Current Setting R_prog I_bat [kOhms] [mA] 10 130 5 250 4 300 3 400 2 580 1.66 690 1.5 780 1.33 900 1.2 1000
R_prog
Sideband Use (SBU) pins unused.
Includes built-in protection for overdischarge, short circuit.
See USB Type-C Spec for resistor values: https://www.usb.org/sites/default/files/USB%20Type-C%20Spec%20R2.0%20-%20August%202019.pdf RP2040 Hardware Design Guide: https://datasheets.raspberrypi.com/rp2040/hardware-design-with-rp2040.pdf
1S LiPo Battery
USB C Connector
Pull down since device is an "Upstream Facing Port" (UFP).

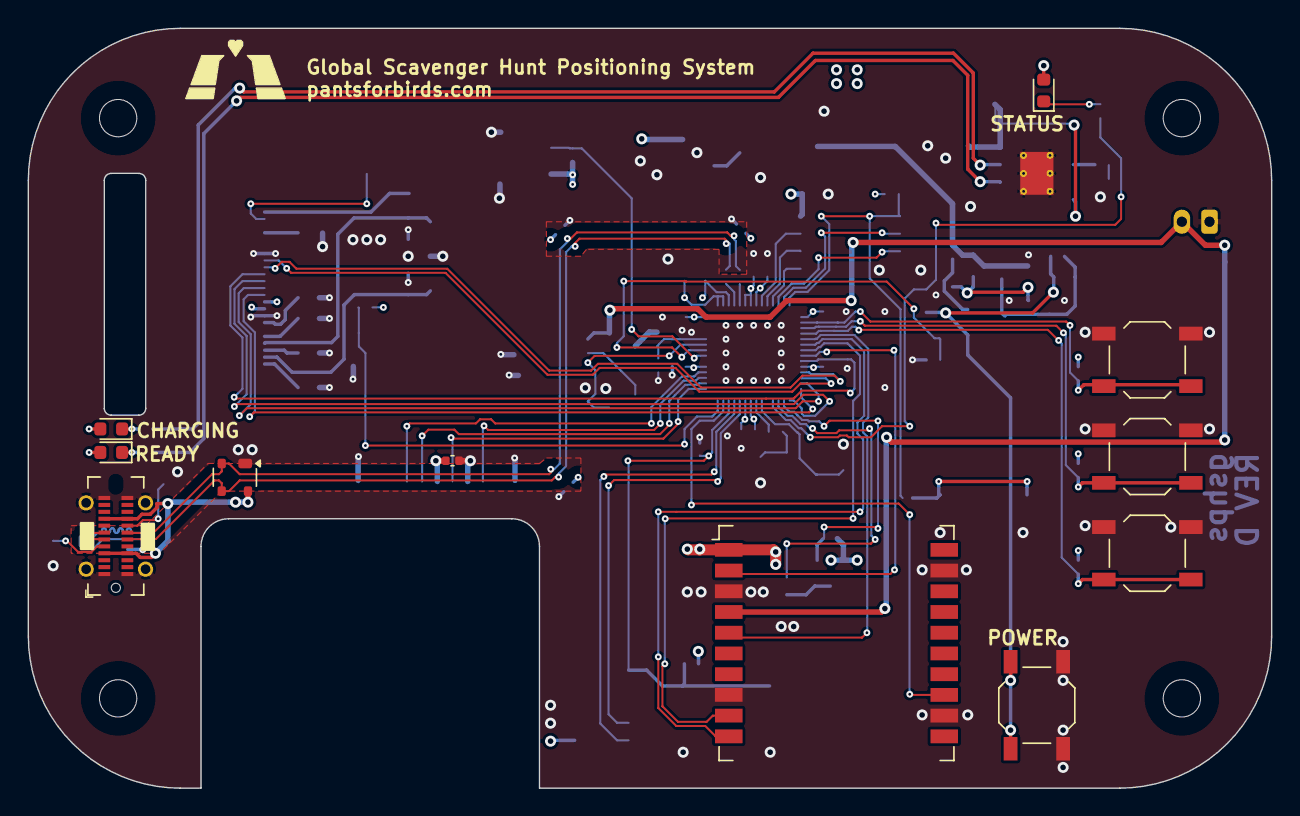
[picture p29: board gshps.kicad_pcb from above]

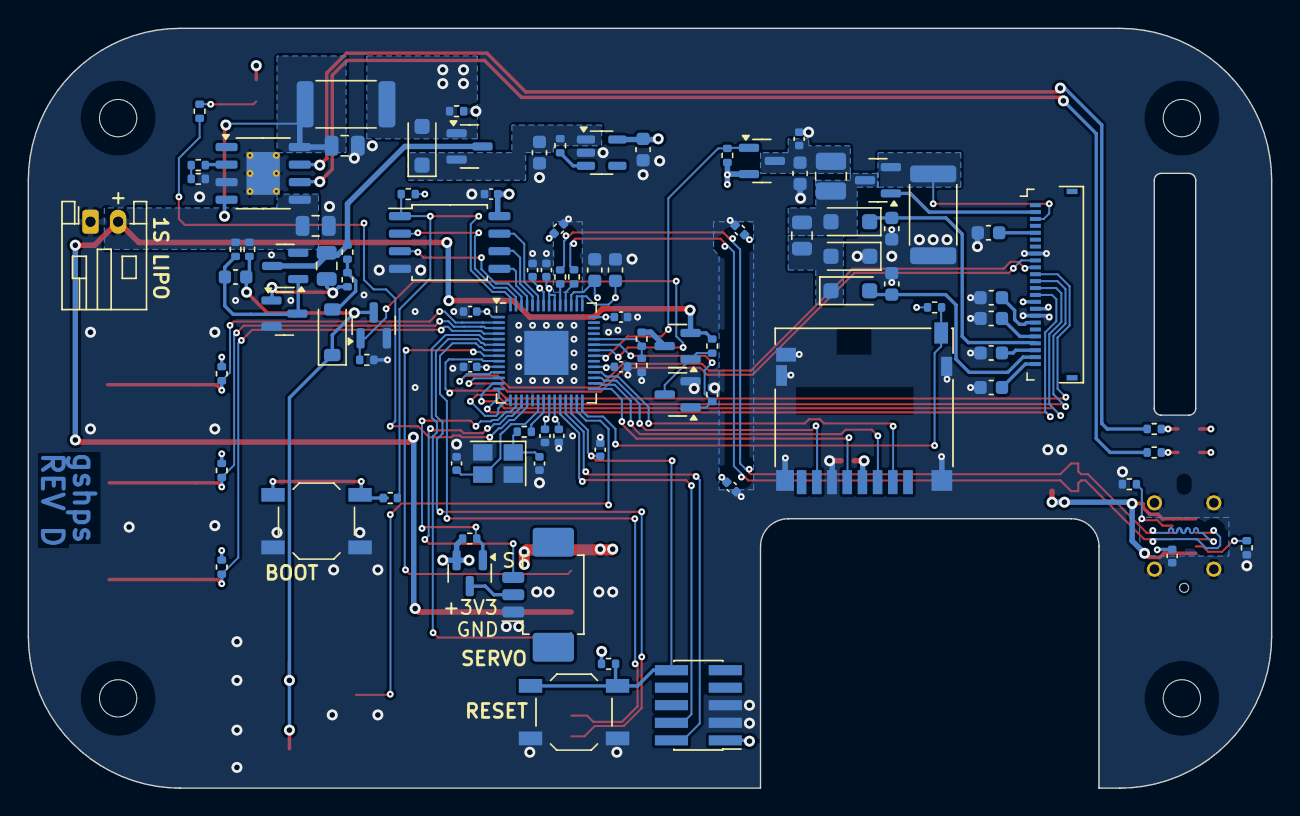
[picture p30: board gshps.kicad_pcb from below]

Board: 4 copper layers, 90.0 x 55.0 mm, 111 parts (94 on the bottom side), 80 nets.
