CoolNamesAllTaken/geeps-hardware/(commit log)

2022-09-24 Add proto
    [geeps_proto.kicad_pcb, geeps_proto.kicad_sch]
2023-06-24 Make geeps mk1 schematic first pass
    [9271K269_Torsion Spring.SLDPRT, geeps_mk1.kicad_pcb, geeps_mk1.kicad_sch, geeps_proto.kicad_pcb, geeps_proto.kicad_sch, thelth_assy.SLDASM, thelth_volume.SLDPRT]
2023-09-03 Routing for geeps mk1
    [geeps_mk1.kicad_pcb, geeps_mk1.kicad_sch]
2023-09-10 GSHPS Rev A
    [geeps_mk1.kicad_pcb, geeps_mk1.kicad_sch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]
2025-01-07 Make gshps rev B
    [geeps_mk1.kicad_pcb, geeps_mk1.kicad_sch, gshps-B_Cu.dxf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]
2025-02-16 Make gshps rev C
    [4x12mm_earring_post.SLDPRT, bottom_wireframe.DXF, design_calculations.xlsx, epaper_display_E2213PS0E1.SLDDRW, epaper_display_E2213PS0E1.SLDPRT, geeps_pcba.SLDASM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]
2025-02-24 Fix BOM export
    [gshps--NPTH_map.gbr, gshps--PTH_map.gbr, gshps-B_Cu.gbl, gshps-B_Cu.gbr, gshps-B_Fab.gbr, gshps-B_Mask.gbr, gshps-B_Mask.gbs, gshps-B_Silkscreen.gbo]
2025-02-26 Design enclosure
    [cover^thelth_assy.STL, frame^thelth_assy.STL, nav_buttons.SLDPRT, nav_buttons.STL, power_button^thelth_assy.STL, thelth_assy.SLDASM]
2025-02-28 GSHPS enclosure
    [access_hatch^access_hatch_thelth_assy.STL, cover^thelth_assy.3mf, frame^thelth_assy.STL, gshps.kicad_pcb, gshps.kicad_sch, micro_servo.SLDPRT, nav_buttons.SLDPRT, nav_buttons.STL]
2025-02-28 Change button height and make access hatch self centering
    [kea.SLDDRW, nav_buttons.SLDPRT, thelth_assy.STEP]
2025-03-05 Save progress before changing access hatch
    [cover^thelth_assy.3mf, nav_buttons.SLDPRT, thelth_assy.STEP]
2025-03-06 Save progress before changing access hatch latch shape.
    [access_hatch^access_hatch_thelth_assy.STL, cover^thelth_assy.3mf, cover^thelth_assy.STL, face_plate^thelth_assy.STEP, frame^thelth_assy.STL, horn_ramp^micro_servo_assy_thelth_assy.STEP, nav_buttons.SLDPRT, nav_buttons.STL]
2025-03-13 Clean up after proposal
    [face_plate^thelth_assy.3mf, frame^thelth_assy.STL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]
